FloppyO1/Automatic-Pet-Feeder/firmware/README.txt

DISPENSER AUTOMATICO CROCCHETTE

CARATTERISTICHE:
- Permette di impostare 3 pasti con 3 differenti quantità e ognuno con un orario scelto, e di poterli attivare o disattivare.
- Integra una batteria in caso di mancanza di alimentazione. Permette di mantenere sia l'ora che i vari pasti impostati.
 > nel caso in cui manchi l'alimentazione per un tempo prolungato potrebbe esserci la perdita delle impostazioni.
 > Una volta ricollegato la bateria verrà ricaricata.
 > Le impostazioni e l'ora si dovrà reimpostare.
- Ogni tipo di pasto può essere impostato con una determinata quantità di cibo (la quantità di cibo non è espressa in g).
- Per navigare nei menu si usa dei pulsanti (+, -, enter) che permettono di selezionare e cambiare i valori nelle impostazioni

MENU:
0. Menu avvio

1. Menu principale
 ? permette di visualizzare i pasti della giornata ancora da fare.
 > in basso a destra c'è il simbolo dell'ingranaggio (sempre selezionato) che permette di entrare nel menu ddelle impostaioni.
 > cliccando il pulsante + si darà una quantità predefinita di cibo, premendo più volte viene aumentata la dose fornita.
 > il pulsante - non fa nulla.

2. Menu impostazioni
 ? permette di navigare nei vari menu di impostazione dei parametri dei pasti, dell'ora e dell'attivazione del dispositivo.
 > in basso a destra c'è l'icona dell'ingranaggio che permette di ritornare al menu principale (selezionabile con i pulsanti + e -).
 > premendo i pulsanti + e - permettono di selezionare il menu al quale si vuole accedere.
 > premendo il pulsante enter si accede al menu selezionato dal puntatore < (o nel caso dell'icona dell'ingranaggio dall'evidenziaione dell'incona stessa).

3. Menu impostazioni pasti (MEAL SET. -> MEAL SETTINGS)
 > permette di attivare/disattivare, impostare il tipo di pasto (quindi la quantità), e l'ora alla quale il pasto deve essere servito.
 >
