FloppyO1/Automatic-Pet-Feeder/hardware/schema pet feeder.jpg

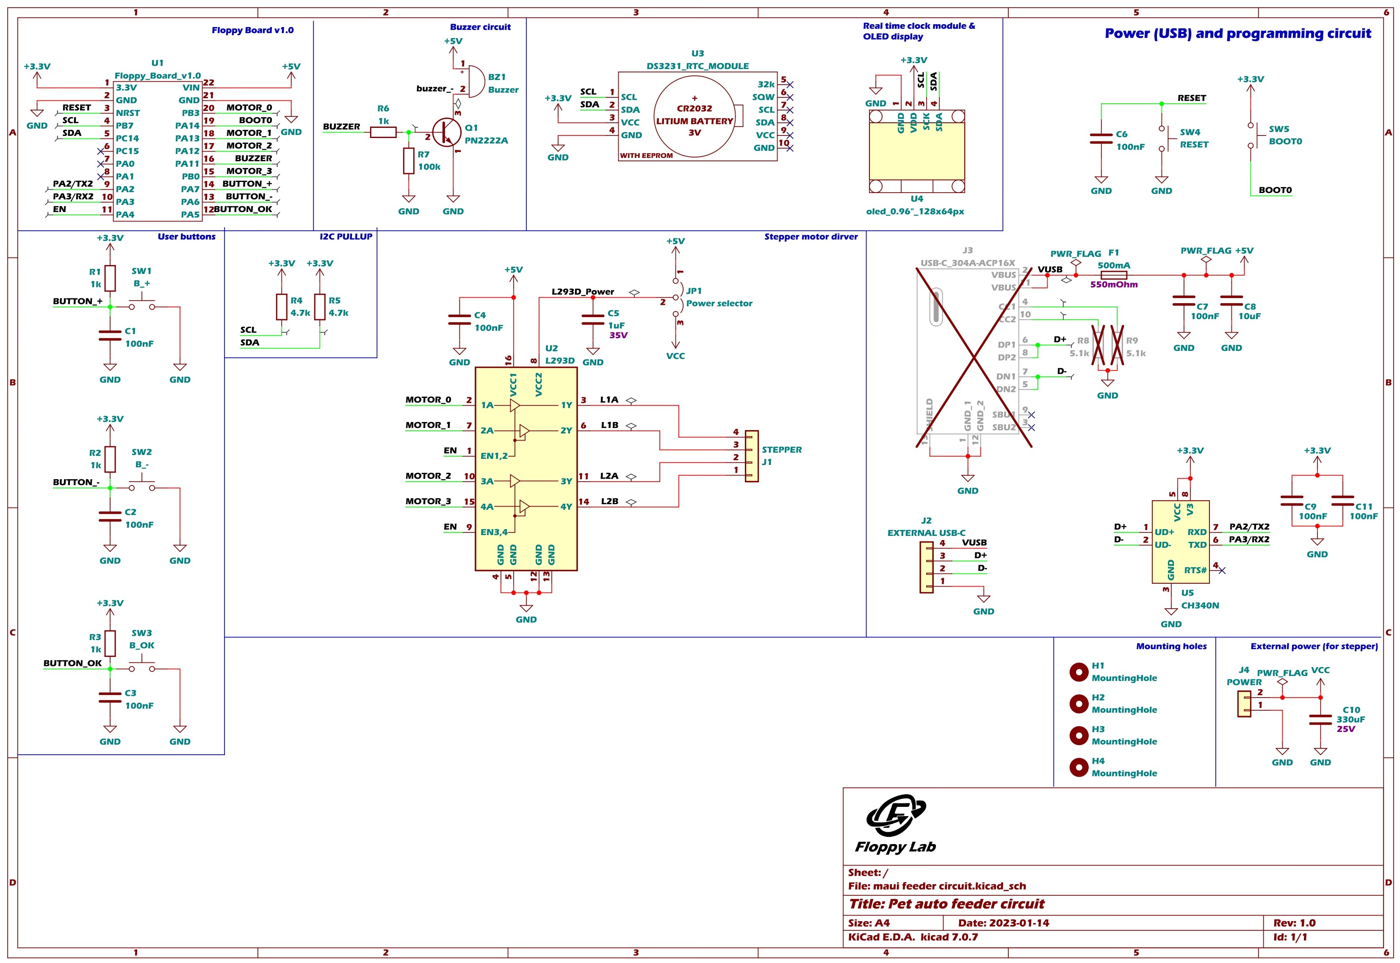
hardware/schema pet feeder.jpg
