FloppyO1/Automatic-Pet-Feeder/hardware/bom Automatic Pet Feeder Control Board.xlsx

REFERENCE | VALUE | FOOTPRINT | QUANTITY
BZ1 | BUZZER | BUZZER P-4mm | 1
C1-C4, C6, C7, C9, C11 | 100 nF | 603 | 8
C5 | 1 uF | 603 | 1
C8 | 10 uF | 603 | 1
C10 | 330 uF | Elec_6.3×7.7mm | 1
F1 | 500mA | 1206 | 1
J1, J2, U3 | connector: stepper/ext_USB/RTC_module | JST_XH_1x4 | 3
J3 | USB-C | USB-C_16pin | 1
J4 | EXT power connector | JST_XH_1x2 | 1
Q1 | PN2222A | TO-92_Inline | 1
R1-R3, R6 | 1 kΩ | 603 | 4
R4, R5 | 4.7 kΩ | 603 | 2
R7 | 100 kΩ | 603 | 1
R8, R9 | 5.1 kΩ | 603 | 2
SW1-SW3 | buttons: +/-/OK | button SMD 5.1×5.1 | 3
SW4, SW5 | buttons: RESET/BOOT0 | button SMD tactile PTS636Sx25 | 2
U2 | L293D | DIP-16 | 1
U4 | Pin Header | Pin Header 1×4 P2.54mm | 1
U5 | CH340N | SOP-8 3.9×4.9mm P1.27mm | 1
