FloppyO1/Automatic-Pet-Feeder/struttura/roba da stampare/dispenser assembly 1.3mf

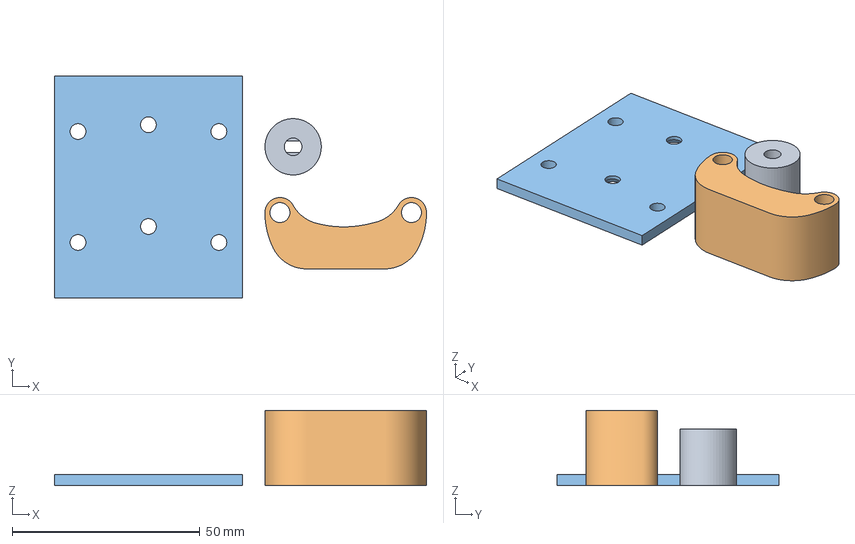
[picture p2: CAD file, 2024-02-22]
struttura/roba da stampare/dispenser assembly 1.3mf
99.0 x 59.0 x 20.0 mm
giunto motore
attacco motore
attacco per ciotola
