FloppyO1/Automatic-Pet-Feeder/struttura/circuito/Assieme case circuito.SLDASM

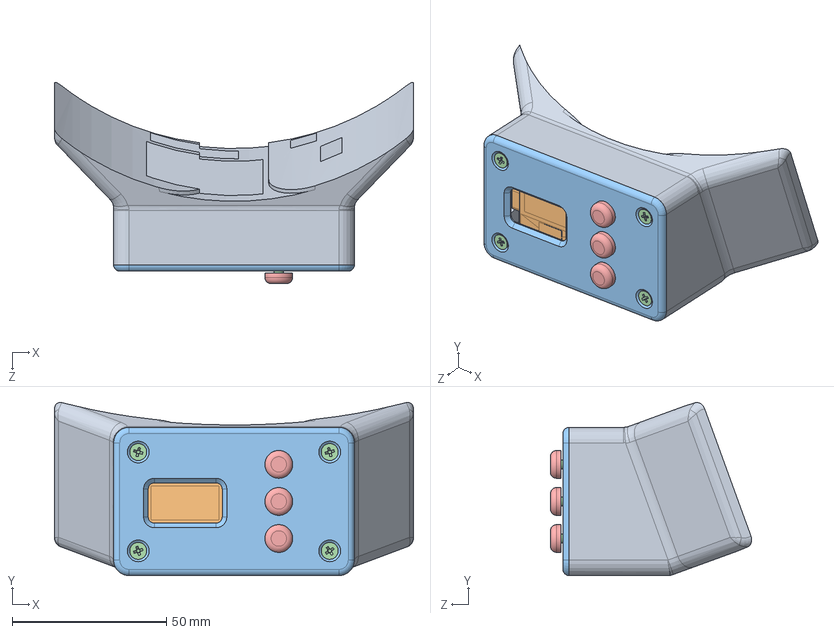
[picture p3: CAD file, 2024-02-22]
struttura/circuito/Assieme case circuito.SLDASM
116.2 x 56.1 x 65.2 mm
case 1
circuito
coperchio case
countersunk flat head cross recess screw_iso x 7
botton 2.0 x 3
