FloppyO1/Automatic-Pet-Feeder/struttura/roba da stampare/dispenser assembly 2.3MF

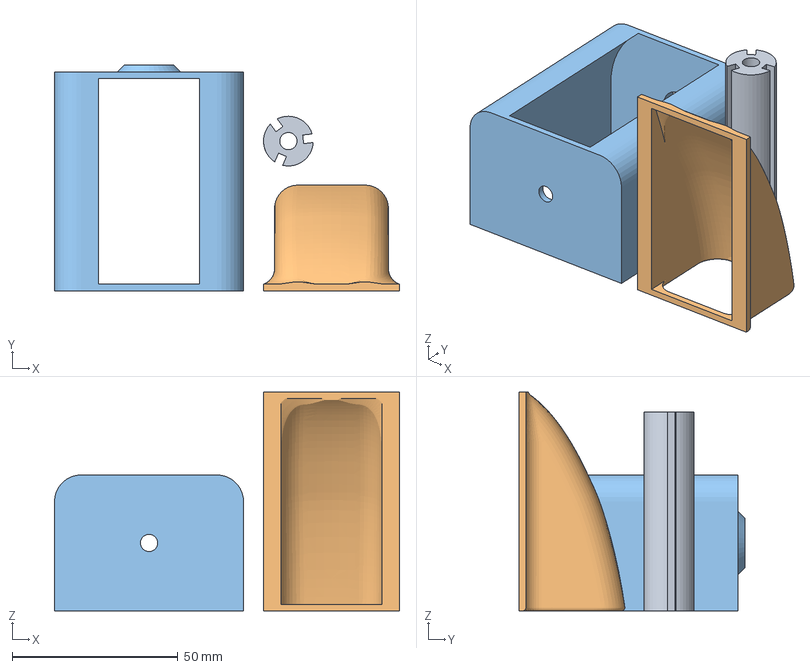
[picture p4: CAD file, 2024-02-22]
struttura/roba da stampare/dispenser assembly 2.3MF
104.0 x 68.0 x 66.0 mm
