FloppyO1/Automatic-Pet-Feeder/struttura/Assieme1 completo.SLDASM

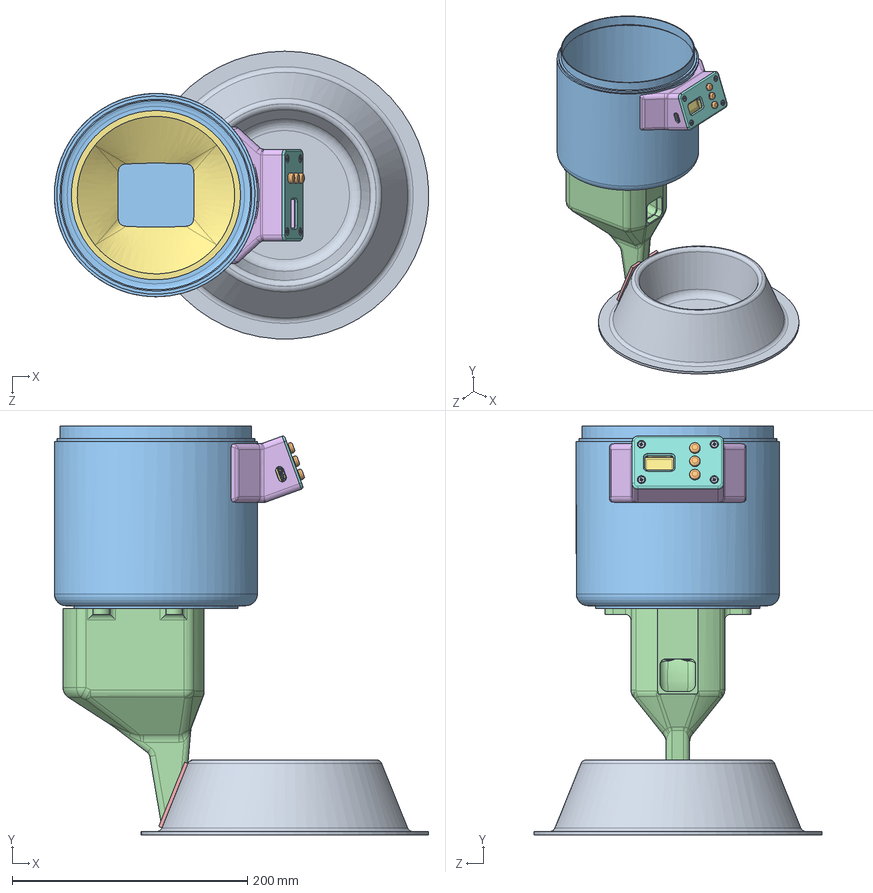
[picture p5: CAD file, 2024-02-22]
struttura/Assieme1 completo.SLDASM
318.6 x 348.0 x 244.8 mm
ciotola
perno rotante
case
convogliatore
giunto motore
attacco motore
cono intern
spazzola x 3
radial ball bearing_68_iso
stepper 24BYJ-48
Bursolotto
sostegno dispenser
attacco per ciotola
case 1
circuito
coperchio case
countersunk flat head cross recess screw_iso x 7
botton 2.0 x 3
