FloppyO1/Automatic-Pet-Feeder/struttura/dispenser/ASSIEME dispenser.SLDASM

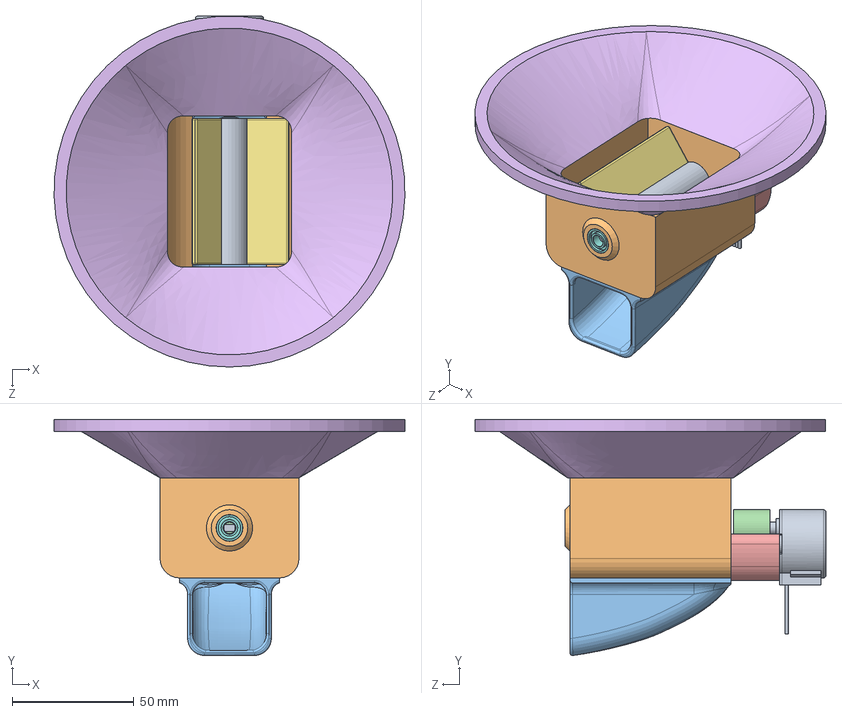
[picture p6: CAD file, 2024-02-22]
struttura/dispenser/ASSIEME dispenser.SLDASM
143.9 x 96.9 x 144.0 mm
perno rotante
case
convogliatore
giunto motore
attacco motore
cono intern
spazzola x 3
radial ball bearing_68_iso
stepper 24BYJ-48
