FloppyO1/Automatic-Pet-Feeder/struttura/attacco per ciotola inclinato .SLDPRT

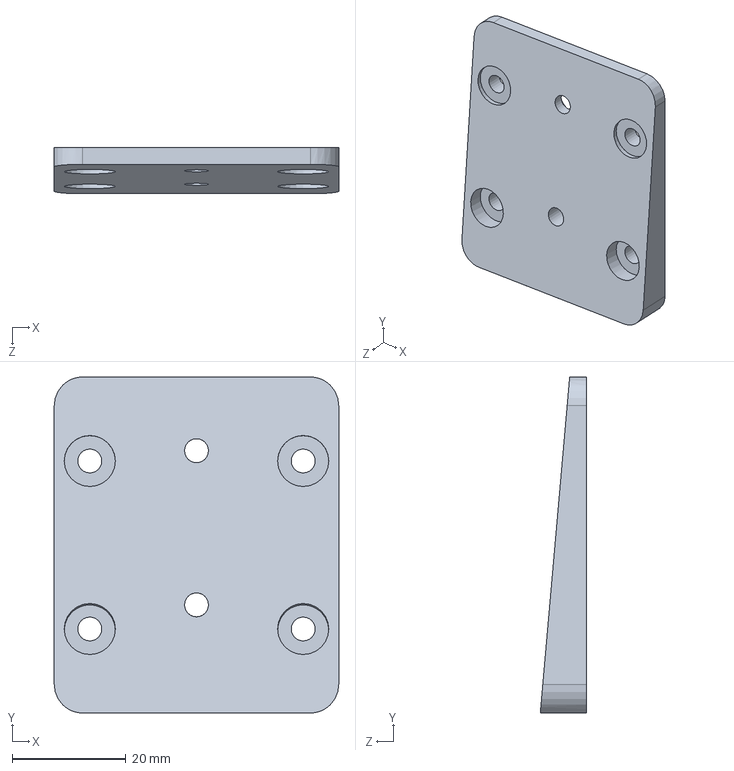
[picture p7: CAD file, 2024-02-22]
struttura/attacco per ciotola inclinato .SLDPRT
50.0 x 59.0 x 8.17 mm
