FloppyO1/Automatic-Pet-Feeder/struttura/circuito/pulsante.SLDPRT

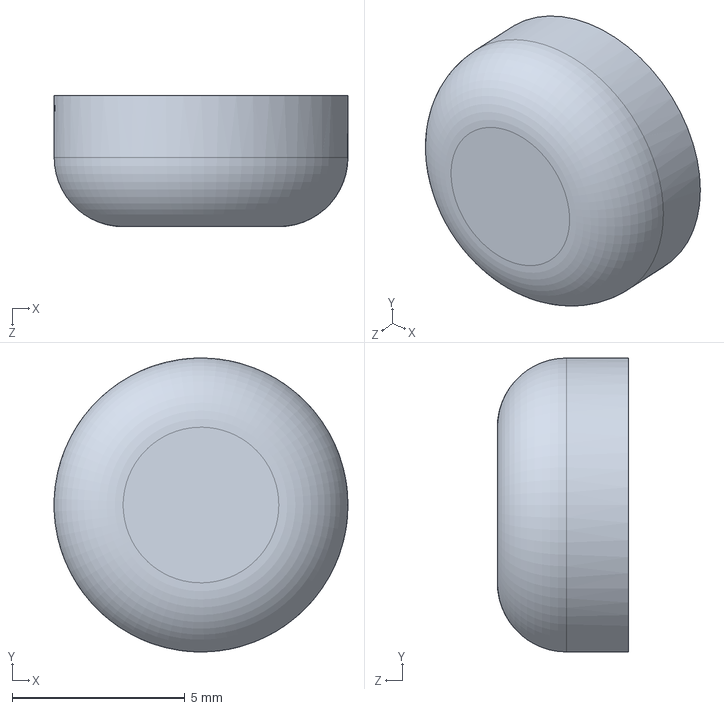
[picture p8: CAD file, 2024-02-22]
struttura/circuito/pulsante.SLDPRT
8.50 x 8.50 x 3.80 mm
