FloppyO1/Automatic-Pet-Feeder/struttura/dispenser/convogliatore.SLDPRT

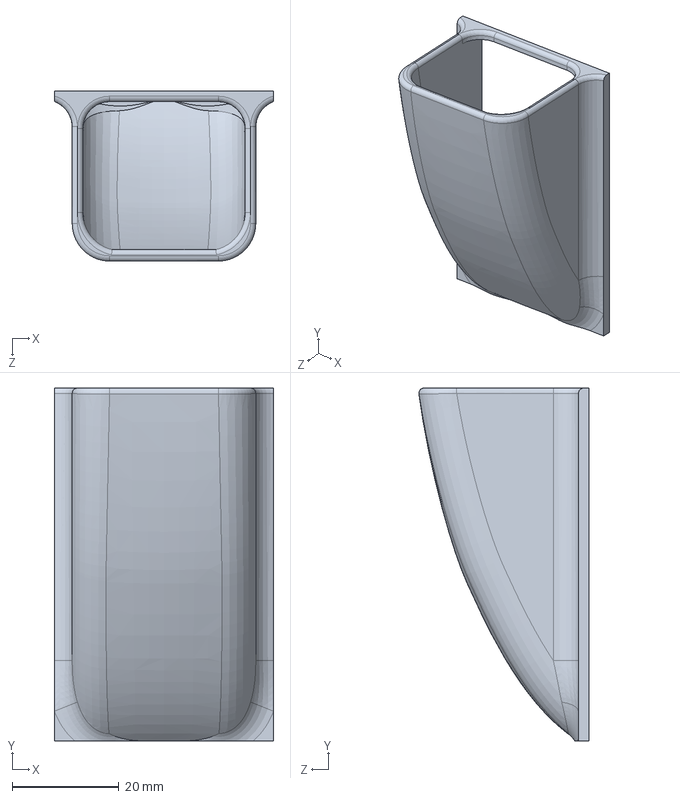
[picture p9: CAD file, 2024-02-22]
struttura/dispenser/convogliatore.SLDPRT
41.0 x 66.0 x 31.9 mm
