FloppyO1/Automatic-Pet-Feeder/struttura/circuito/coperchio case.SLDPRT

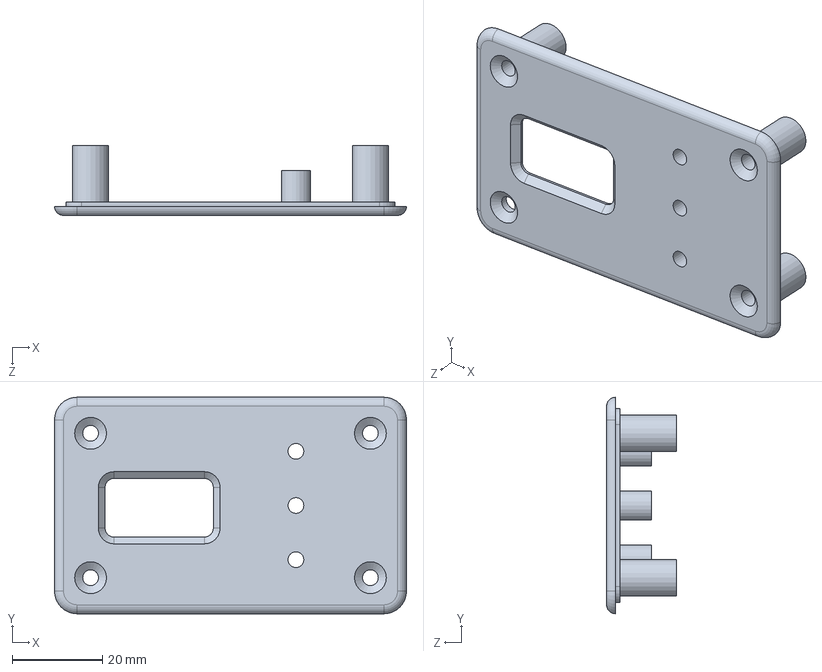
[picture p10: CAD file, 2024-02-22]
struttura/circuito/coperchio case.SLDPRT
78.0 x 48.0 x 15.5 mm
