FloppyO1/Automatic-Pet-Feeder/struttura/dispenser/perno rotante.SLDPRT

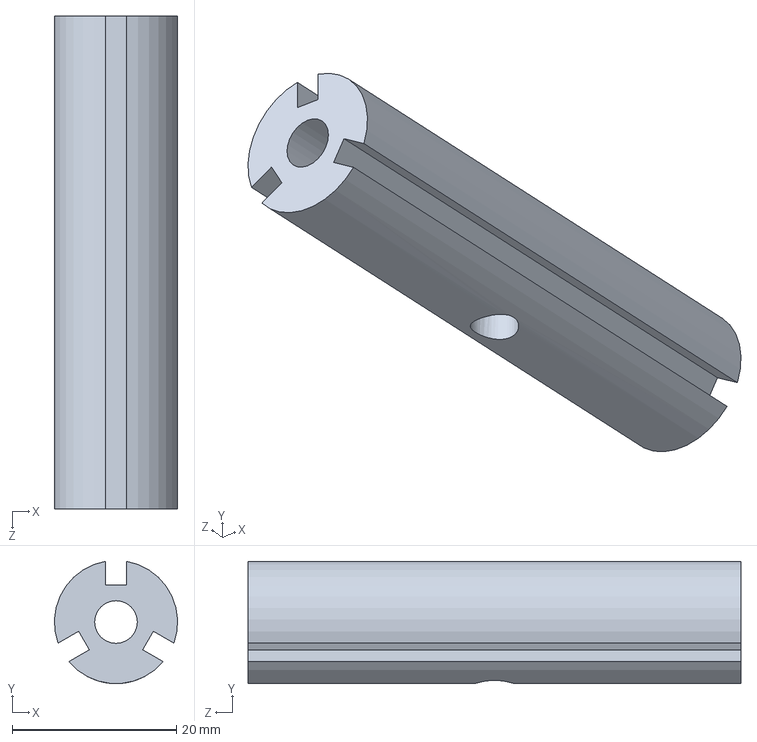
[picture p11: CAD file, 2024-02-22]
struttura/dispenser/perno rotante.SLDPRT
15.0 x 14.9 x 60.0 mm
