FloppyO1/Automatic-Pet-Feeder/struttura/roba da stampare/funnel.3MF

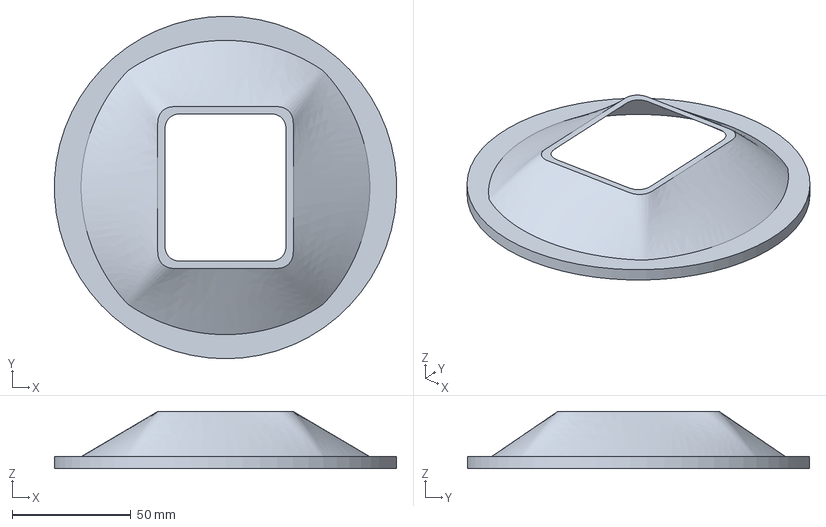
[picture p12: CAD file, 2024-02-22]
struttura/roba da stampare/funnel.3MF
143.8 x 144.0 x 24.0 mm
