FloppyO1/Automatic-Pet-Feeder/struttura/stepper 24BYJ-48.SLDPRT

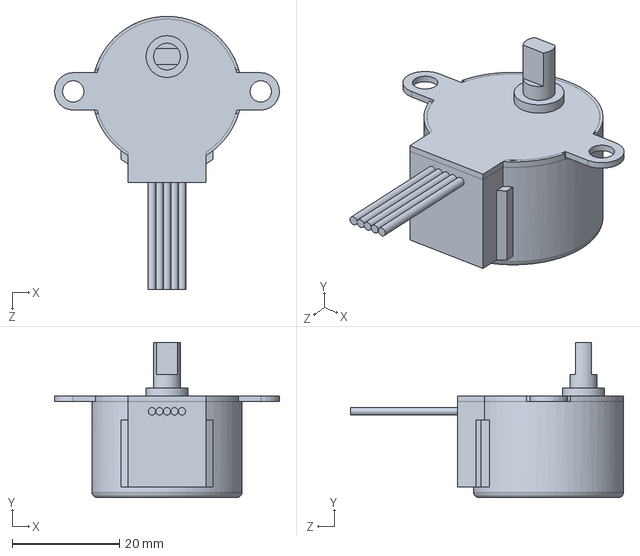
[picture p13: CAD file, 2024-02-22]
struttura/stepper 24BYJ-48.SLDPRT
42.0 x 29.0 x 51.0 mm
