FloppyO1/Automatic-Pet-Feeder/struttura/Bursolotto.SLDPRT

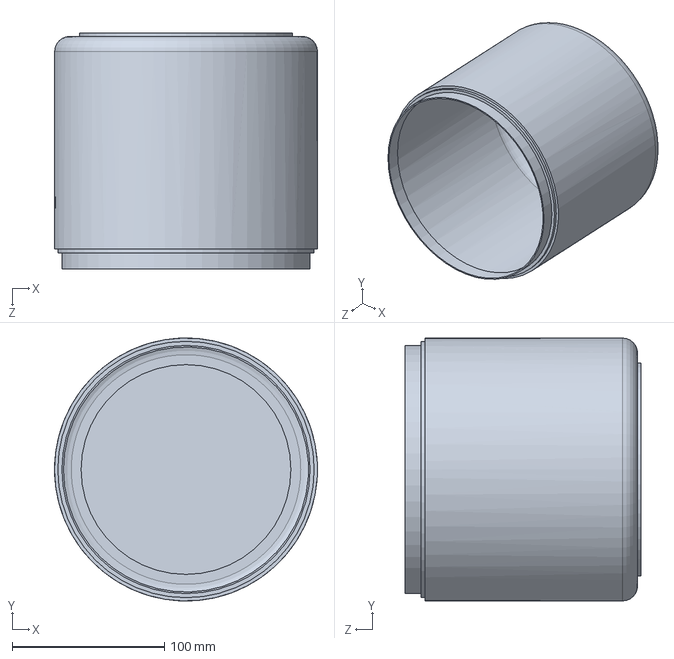
[picture p14: CAD file, 2024-02-22]
struttura/Bursolotto.SLDPRT
173.0 x 173.0 x 155.2 mm
