FloppyO1/Automatic-Pet-Feeder/struttura/circuito/case 1.SLDPRT

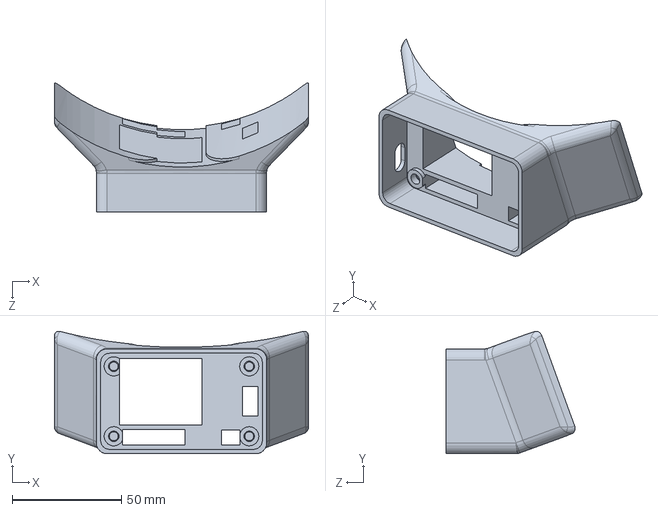
[picture p15: CAD file, 2024-02-22]
struttura/circuito/case 1.SLDPRT
116.2 x 56.1 x 59.1 mm
