FloppyO1/Automatic-Pet-Feeder/struttura/dispenser/spazzola.SLDPRT

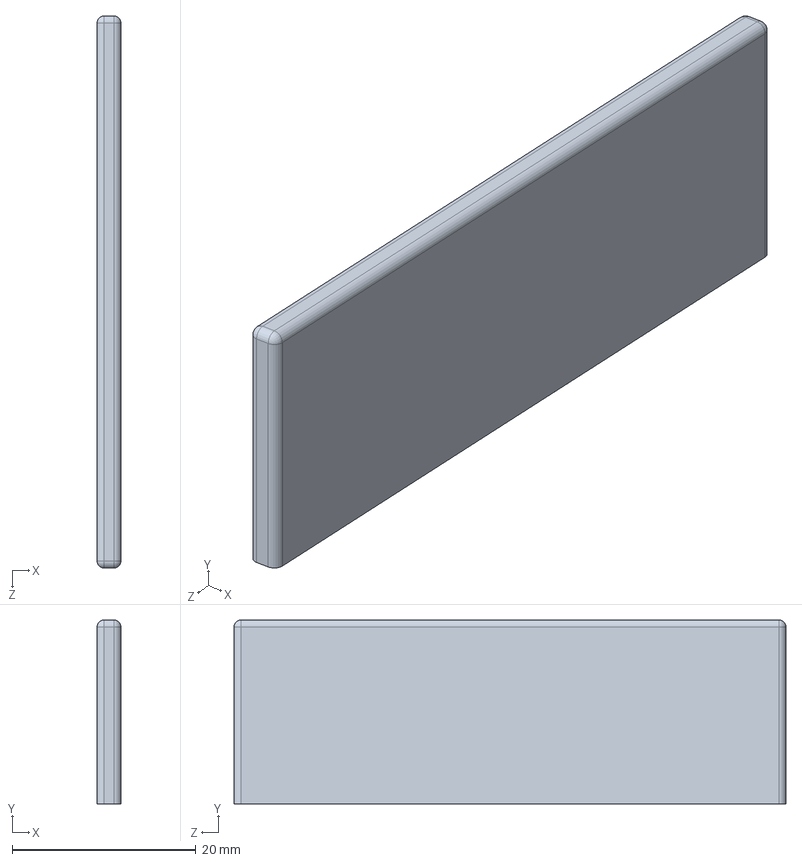
[picture p16: CAD file, 2024-02-22]
struttura/dispenser/spazzola.SLDPRT
2.60 x 20.0 x 60.0 mm
