FloppyO1/Automatic-Pet-Feeder/struttura/attacco motore.SLDPRT

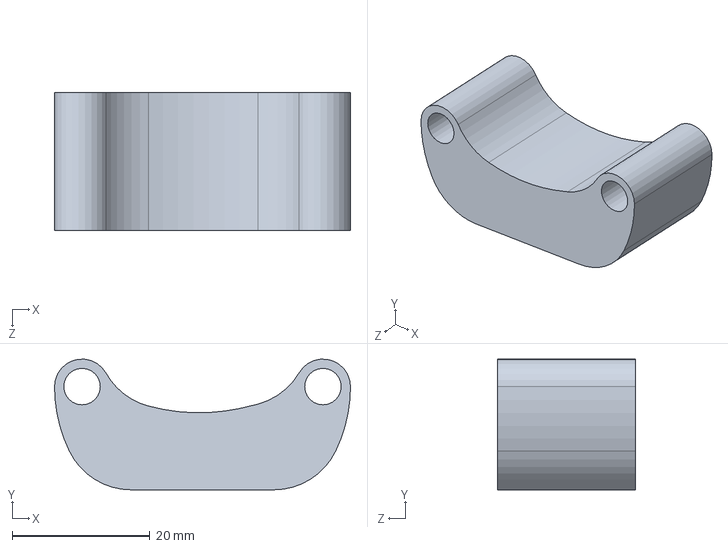
[picture p17: CAD file, 2024-02-22]
struttura/attacco motore.SLDPRT
43.0 x 19.0 x 20.0 mm
