FloppyO1/Automatic-Pet-Feeder/struttura/circuito/botton 2.0.SLDPRT

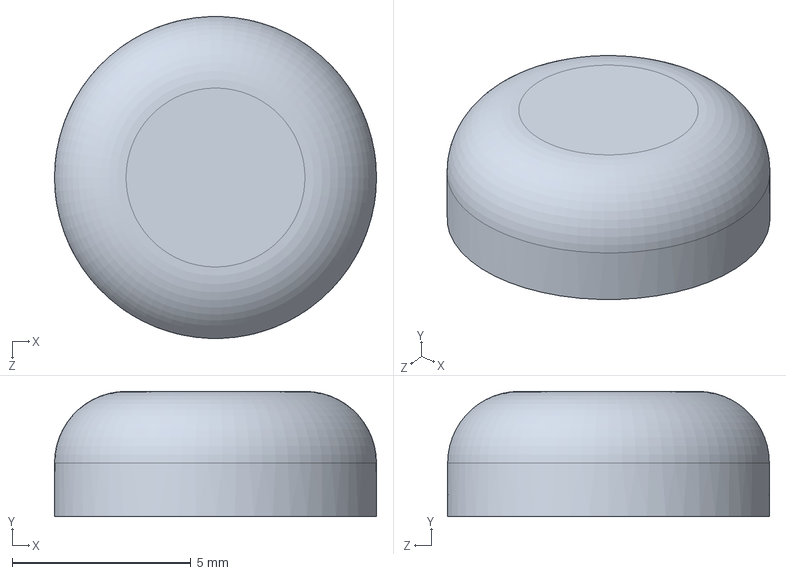
[picture p18: CAD file, 2024-02-22]
struttura/circuito/botton 2.0.SLDPRT
9.00 x 3.50 x 9.00 mm
