FloppyO1/Automatic-Pet-Feeder/struttura/roba da stampare/dispenser mount.3MF

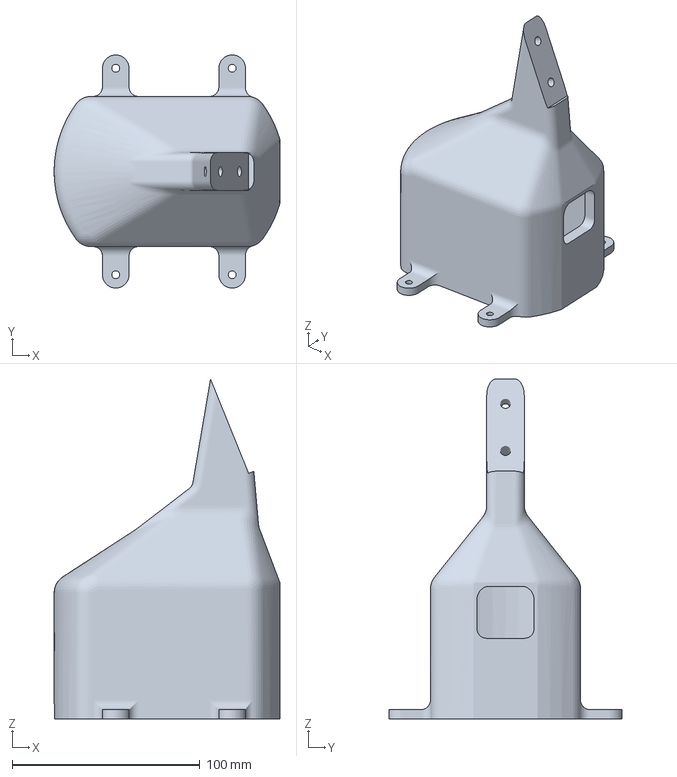
[picture p19: CAD file, 2024-02-22]
struttura/roba da stampare/dispenser mount.3MF
120.2 x 124.2 x 181.1 mm
