FloppyO1/Automatic-Pet-Feeder/struttura/attacco per ciotola.SLDPRT

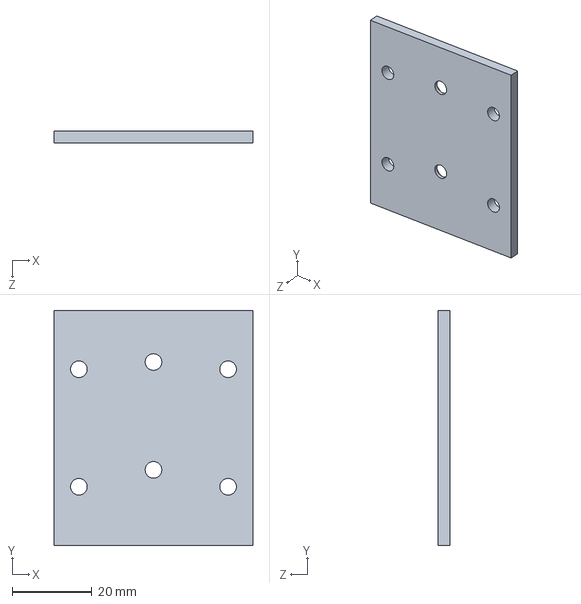
[picture p20: CAD file, 2024-02-22]
struttura/attacco per ciotola.SLDPRT
50.0 x 59.0 x 3.00 mm
