FloppyO1/Automatic-Pet-Feeder/struttura/roba da stampare/circuit case.3MF

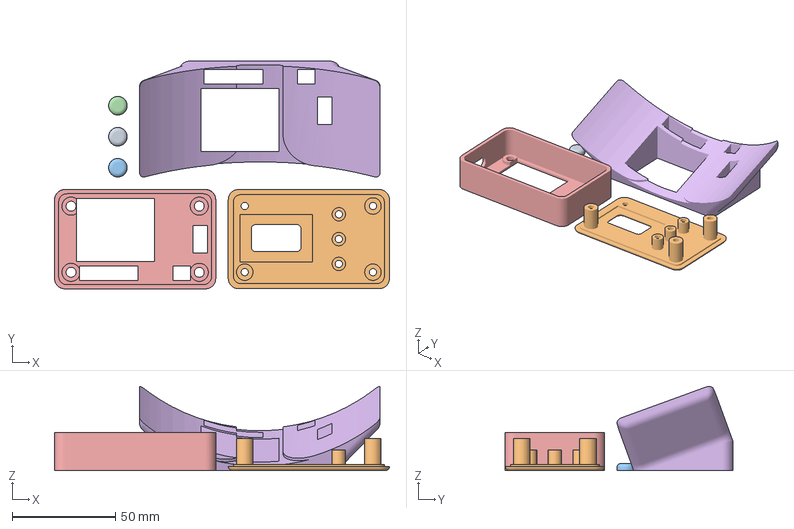
[picture p21: CAD file, 2024-02-22]
struttura/roba da stampare/circuit case.3MF
162.0 x 110.1 x 40.7 mm
