FloppyO1/Automatic-Pet-Feeder/struttura/dispenser/case.SLDPRT

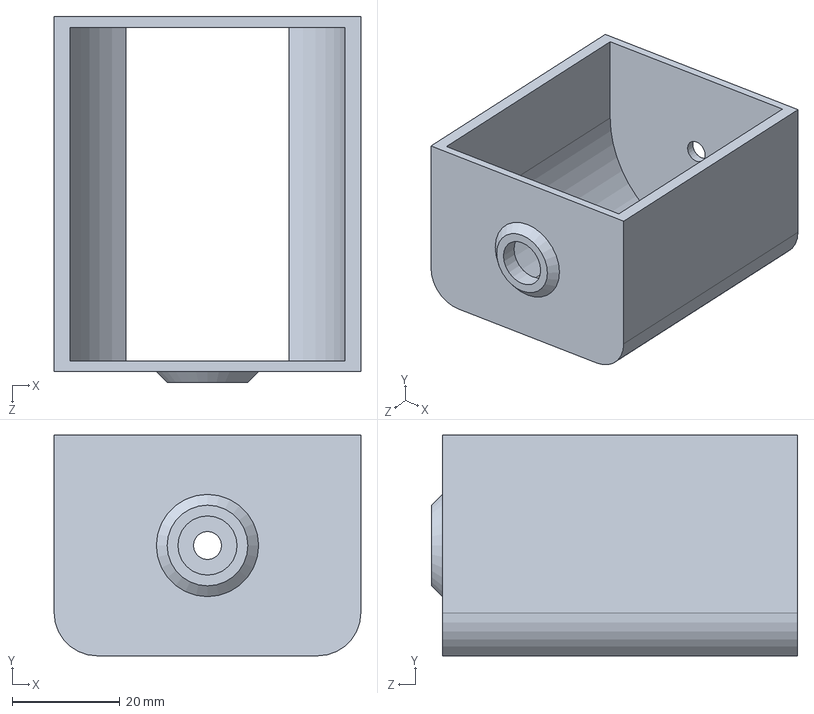
[picture p22: CAD file, 2024-02-22]
struttura/dispenser/case.SLDPRT
57.0 x 41.0 x 68.0 mm
