FloppyO1/Automatic-Pet-Feeder/struttura/dispenser/ciotola.SLDPRT

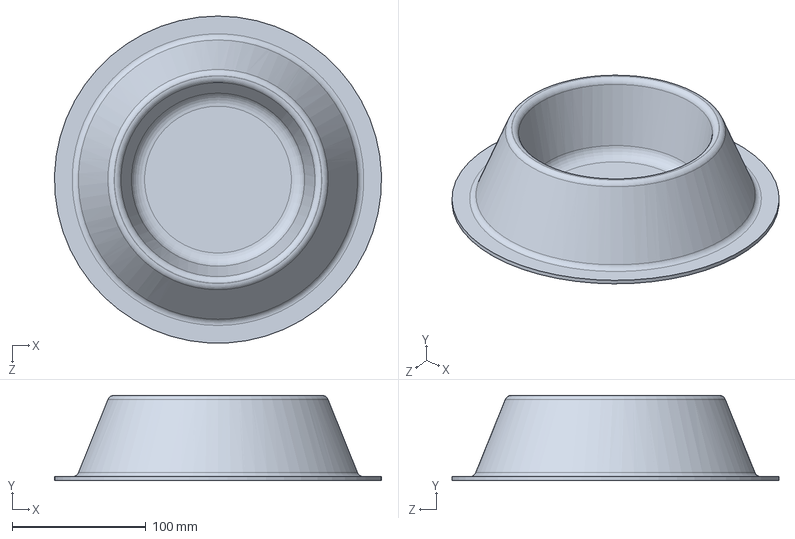
[picture p23: CAD file, 2024-02-22]
struttura/dispenser/ciotola.SLDPRT
244.9 x 64.0 x 244.8 mm
