FloppyO1/Automatic-Pet-Feeder/struttura/giunto motore.SLDPRT

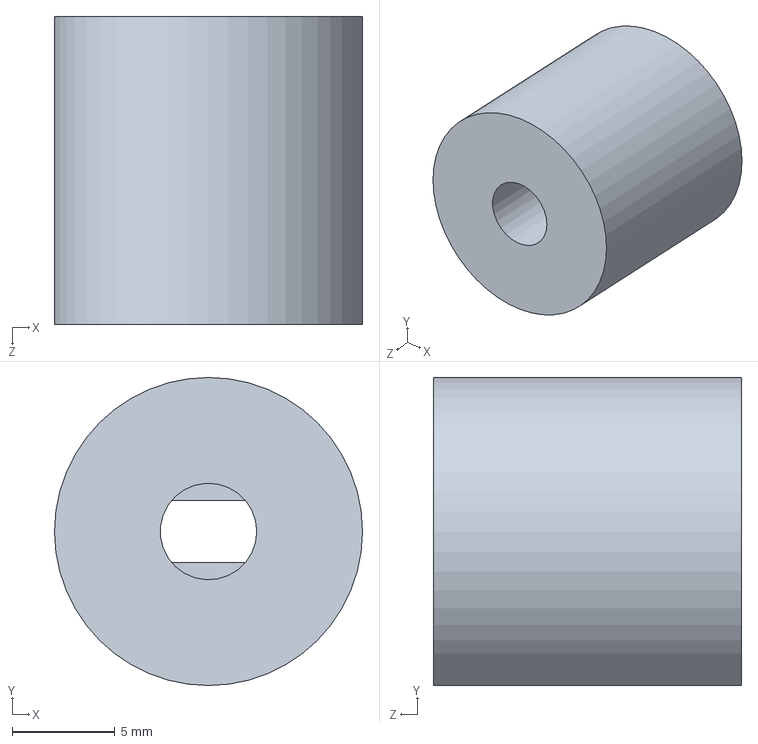
[picture p24: CAD file, 2024-02-22]
struttura/giunto motore.SLDPRT
15.0 x 15.0 x 15.0 mm
