FloppyO1/Automatic-Pet-Feeder/(list of files, cad)

Other CAD files:
struttura/roba da stampare/attacco per ciotola inclinato .3MF
struttura/dispenser/LID1.SLDPRT
struttura/dispenser/LID3.SLDPRT
struttura/sostegno dispenser.SLDPRT
struttura/dispenser/cono intern.SLDPRT
struttura/dispenser/LID2.SLDPRT
