FloppyO1/Automatic-Pet-Feeder/hardware/schema pet feeder.pdf

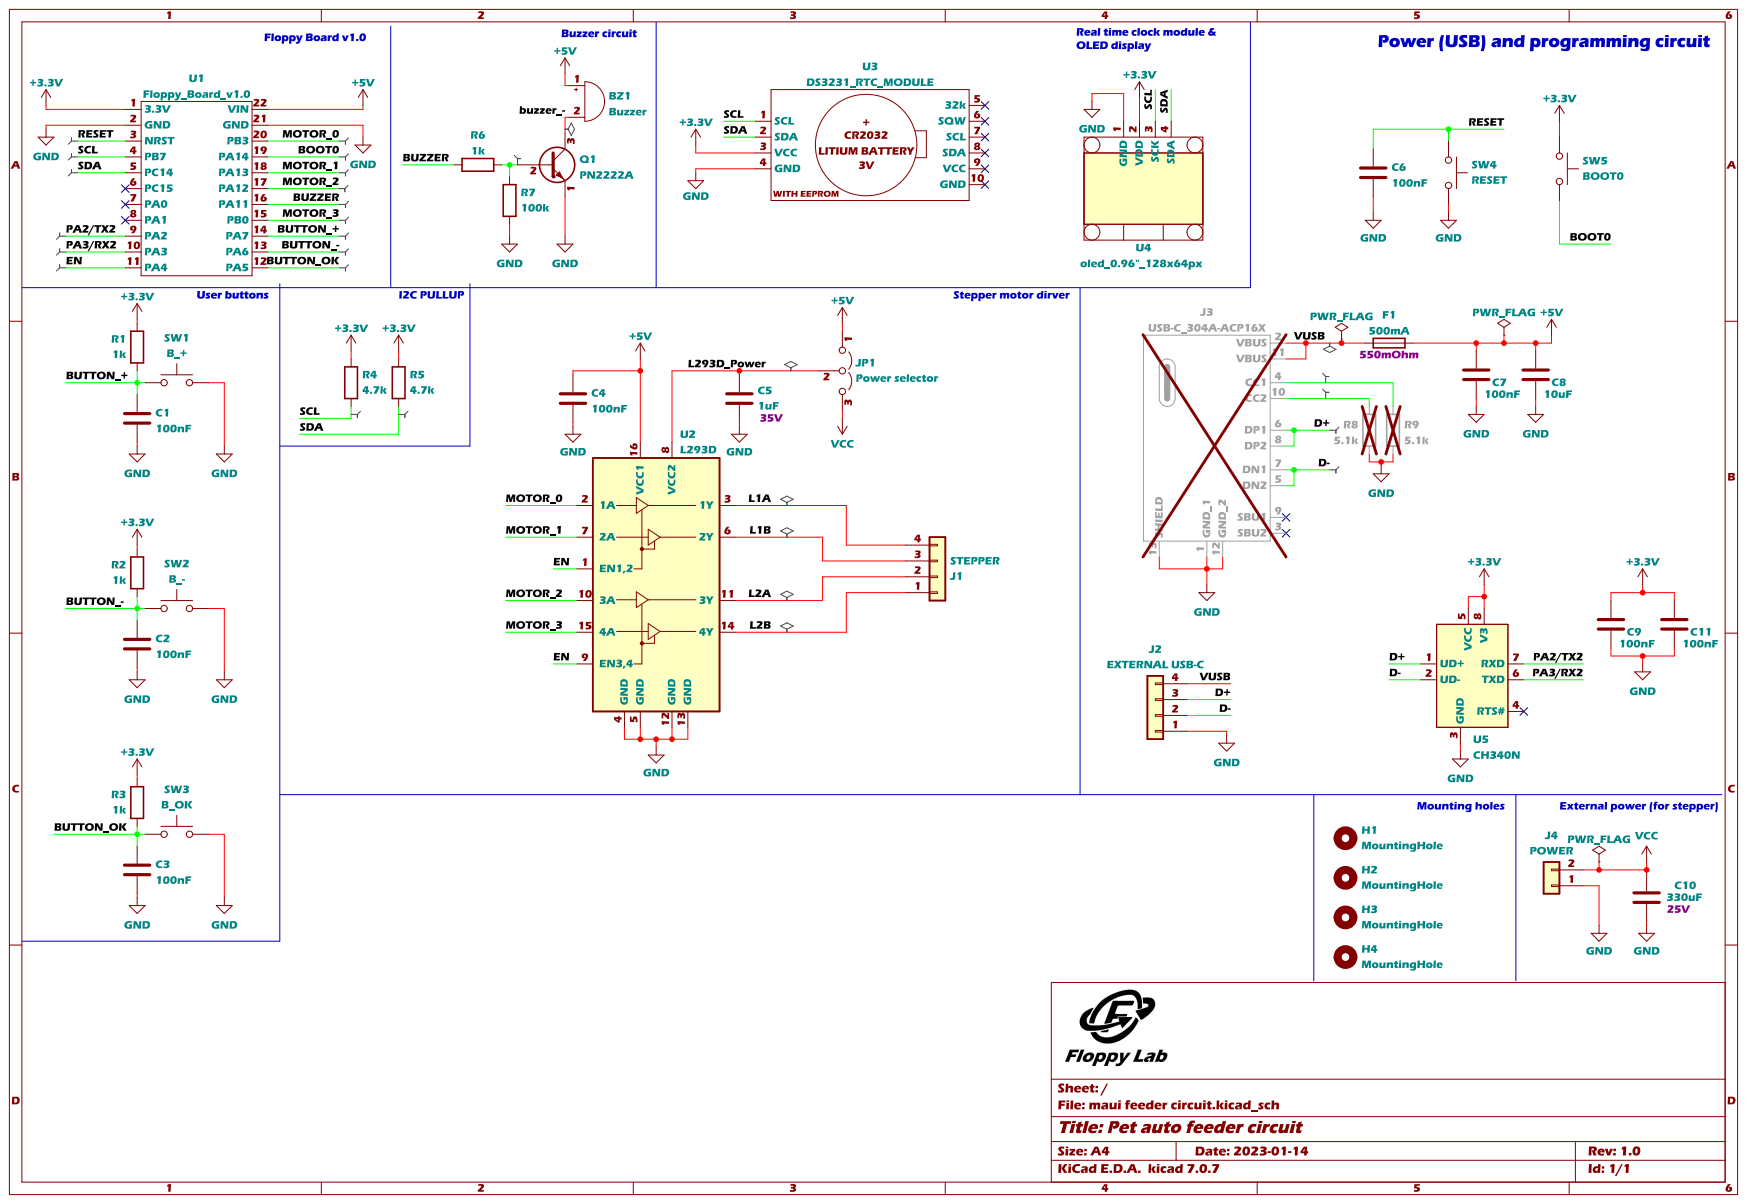
[picture p25: page 1]
