FloppyO1/Automatic-Pet-Feeder/hardware/maui feeder circuit/maui feeder circuit.kicad_pcb

## KiCad design hardware/maui feeder circuit/maui feeder circuit.kicad_pcb (2024-02-22)

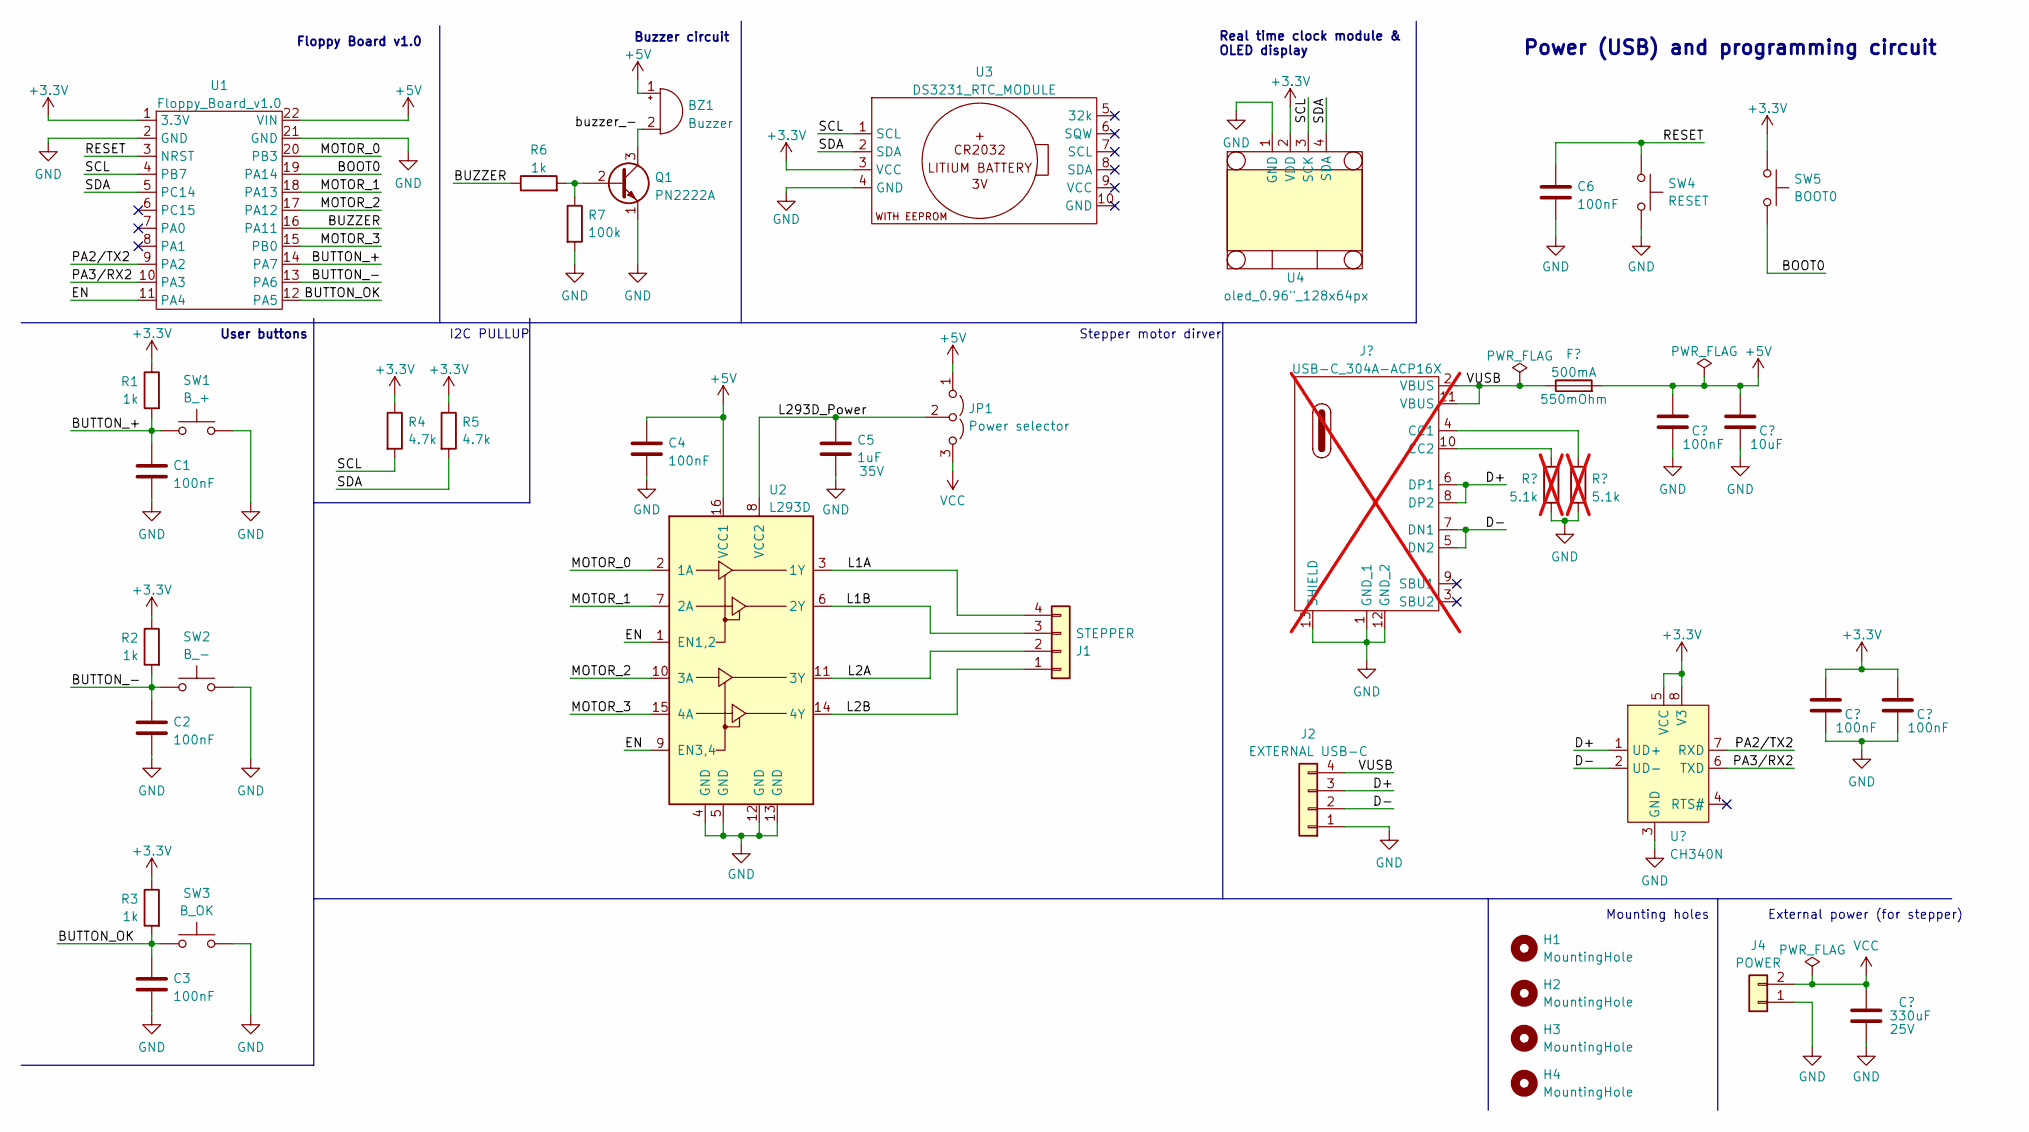
[picture p26: schematic maui feeder circuit.kicad_sch, Pet auto feeder circuit]

Parts:
BZ1: Buzzer; MagneticBuzzer_PUI_AT-0927-TT-6-R
C1, C2, C3, C4, C6, C7, C9, C11: 100nF; C_0603_1608Metric
C5: 1uF; C_0603_1608Metric; Voltage 35V
C8: 10uF; C_0603_1608Metric
C10: 330uF; CP_Elec_6.3x7.7; Voltage 25V
F1: 500mA; Fuse_1206_3216Metric_Pad1.42x1.75mm_HandSolder
H1, H2, H3, H4: MountingHole; MountingHole_3.2mm_M3_Pad
J1: STEPPER; JST_XH_B4B-XH-A_1x04_P2.50mm_Vertical
J2: EXTERNAL USB-C; JST_XH_B4B-XH-A_1x04_P2.50mm_Vertical
J3: USB-C_304A-ACP16X; USB_C_304A-ACP16X; not fitted
J4: POWER; JST_XH_B2B-XH-A_1x02_P2.50mm_Vertical
JP1: Power selector; SolderJumper-3_P1.3mm_Open_RoundedPad1.0x1.5mm
Q1: PN2222A; TO-92_Inline
R1, R2, R3, R6: 1k; R_0603_1608Metric
R4, R5: 4.7k; R_0603_1608Metric
R7: 100k; R_0603_1608Metric
R8, R9: 5.1k; R_0603_1608Metric; not fitted
SW1: B_+; SMD BUTTON 5.1x5.1
SW2: B_-; SMD BUTTON 5.1x5.1
SW3: B_OK; SMD BUTTON 5.1x5.1
SW4: RESET; SW_Tactile_SPST_NO_Straight_CK_PTS636Sx25SMTRLFS
SW5: BOOT0; SW_Tactile_SPST_NO_Straight_CK_PTS636Sx25SMTRLFS
U1: Floppy_Board_v1.0; Floppy board v1.0
U2: L293D; DIP-16_W7.62mm
U3: DS3231_RTC_MODULE; JST_XH_B4B-XH-A_1x04_P2.50mm_Vertical
U4: oled_0.96"_128x64px; 128x64OLED
U5: CH340N; SOP-8_3.9x4.9mm_P1.27mm

Connections:
+3.3V: C9.1, C11.1, R1.1, R2.1, R3.1, R4.1, R5.1, SW5.1, U1.1 (3.3V), U3.3 (VCC), U4.2 (VDD), U5.5 (VCC), U5.8 (V3)
+5V: BZ1.1 (-), C4.1, C7.1, C8.1, F1.2, JP1.1 (A), U1.22 (VIN), U2.16 (VCC1)
/BOOT0: SW5.2, U1.19 (PA14)
/BUTTON_+: C1.1, R1.2, SW1.1, U1.14 (PA7)
/BUTTON_-: C2.1, R2.2, SW2.1, U1.13 (PA6)
/BUTTON_OK: C3.1, R3.2, SW3.1, U1.12 (PA5)
/BUZZER: R6.1, U1.16 (PA11)
/D+: J2.3, J3.6 (DP1), J3.8 (DP2), U5.1 (UD+)
/D-: J2.2, J3.5 (DN2), J3.7 (DN1), U5.2 (UD-)
/EN: U1.11 (PA4), U2.1 (EN1,2), U2.9 (EN3,4)
/L1A: J1.4, U2.3 (1Y)
/L1B: J1.3, U2.6 (2Y)
/L2A: J1.2, U2.11 (3Y)
/L2B: J1.1, U2.14 (4Y)
/L293D_Power: C5.1, JP1.2 (C), U2.8 (VCC2)
/MOTOR_0: U1.20 (PB3), U2.2 (1A)
/MOTOR_1: U1.18 (PA13), U2.7 (2A)
/MOTOR_2: U1.17 (PA12), U2.10 (3A)
/MOTOR_3: U1.15 (PB0), U2.15 (4A)
/PA2/TX2: U1.9 (PA2), U5.7 (RXD)
/PA3/RX2: U1.10 (PA3), U5.6 (TXD)
/RESET: C6.1, SW4.1, U1.3 (NRST)
/SCL: R4.2, U1.4 (PB7), U3.1 (SCL), U4.3 (SCK)
/SDA: R5.2, U1.5 (PC14), U3.2 (SDA), U4.4 (SDA)
/VUSB: F1.1, J2.4, J3.2 (VBUS), J3.11 (VBUS)
/buzzer_-: BZ1.2 (+), Q1.3 (C)
GND: C1.2, C2.2, C3.2, C4.2, C5.2, C6.2, C7.2, C8.2, C9.2, C10.2, C11.2, J2.1, J3.1 (GND_1), J3.12 (GND_2), J3.13 (SHIELD), J4.1, Q1.1 (E), R7.2, R8.1, R9.2, SW1.2, SW2.2, SW3.2, SW4.2, U1.2 (GND), U1.21 (GND), U2.4 (GND), U2.5 (GND), U2.12 (GND), U2.13 (GND), U3.4 (GND), U4.1 (GND), U5.3 (GND)
unnamed: J3.4 (CC1), R9.1
unnamed: J3.10 (CC2), R8.2
unnamed: Q1.2 (B), R6.2, R7.1
VCC: C10.1, J4.2, JP1.3 (B)

Notes on the sheet:
External power (for stepper)
Stepper motor dirver
Real time clock module & OLED display
Buzzer circuit
Power (USB) and programming circuit
I2C PULLUP
Floppy Board v1.0
User buttons
Mounting holes

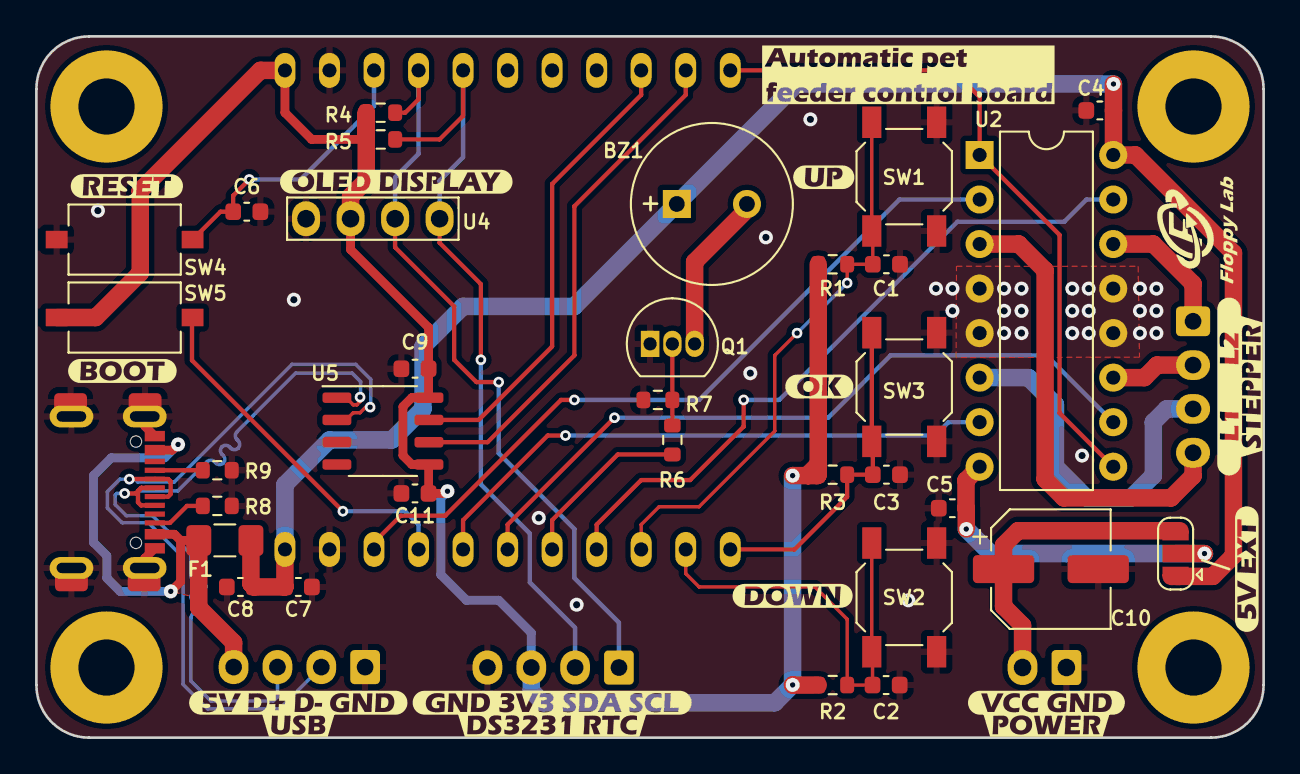
[picture p27: board maui feeder circuit.kicad_pcb from above]

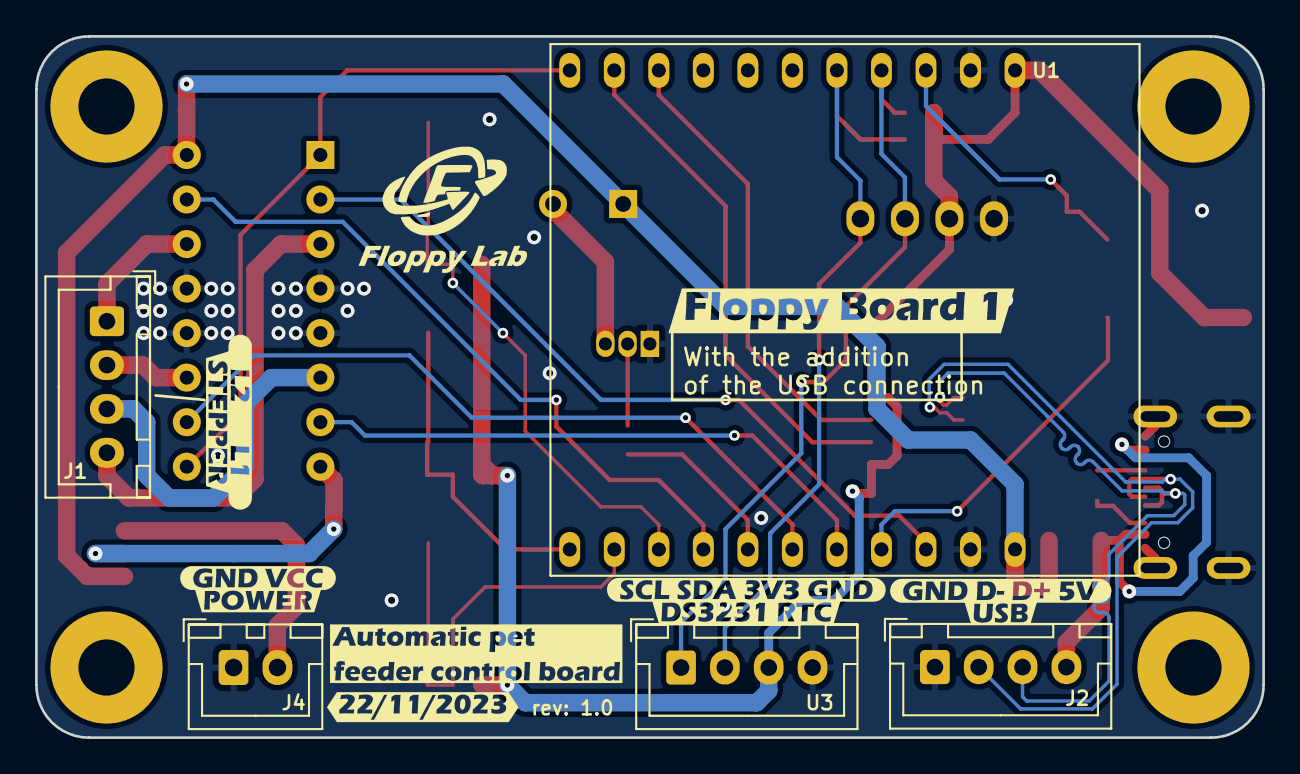
[picture p28: board maui feeder circuit.kicad_pcb from below]

Board: 2 copper layers, 70.0 x 40.0 mm, 69 parts (16 on the bottom side), 31 nets.

Other parts of the board:
kibuzzard-655E5A8C, kibuzzard-655E5A8C#2: G***; kibuzzard-655E5A8C
kibuzzard-655E5A9C: G***; kibuzzard-655E5A9C
kibuzzard-655E5ABC: G***; kibuzzard-655E5ABC
kibuzzard-655E5B7A: G***; kibuzzard-655E5B7A
kibuzzard-655E5B48: G***; kibuzzard-655E5B48
kibuzzard-655E5B52, kibuzzard-655E5B52#2: G***; kibuzzard-655E5B52
kibuzzard-655E5B87: G***; kibuzzard-655E5B87
kibuzzard-655E5B91: G***; kibuzzard-655E5B91
kibuzzard-655E5BB9: G***; kibuzzard-655E5BB9
kibuzzard-655E5BC2: G***; kibuzzard-655E5BC2
kibuzzard-655E6B51: G***; kibuzzard-655E6B51
kibuzzard-655E6C3A, kibuzzard-655E6C3A#2: G***; kibuzzard-655E6C3A
kibuzzard-655E6C5E: G***; kibuzzard-655E6C5E
kibuzzard-655E6CD0: G***; kibuzzard-655E6CD0
kibuzzard-655E6CF0: G***; kibuzzard-655E6CF0
kibuzzard-655E6D66: G***; kibuzzard-655E6D66
kibuzzard-655E6DEF: G***; kibuzzard-655E6DEF
kibuzzard-655E59BB, kibuzzard-655E59BB#2: G***; kibuzzard-655E59BB
kibuzzard-655E59DB, kibuzzard-655E59DB#2: G***; kibuzzard-655E59DB
kibuzzard-655E59EA: G***; kibuzzard-655E59EA
kibuzzard-655E71CE: G***; kibuzzard-655E71CE
kibuzzard-655E598F: G***; kibuzzard-655E598F
