FloppyO1/Automatic-Pet-Feeder/firmware/automatic pet feeder/Core/Inc/main.h

#define USER_LED_Pin GPIO_PIN_15
#define USER_LED_GPIO_Port GPIOC
#define ENTER_B_Pin GPIO_PIN_5
#define ENTER_B_GPIO_Port GPIOA
#define ENTER_B_EXTI_IRQn EXTI4_15_IRQn
#define MINUS_B_Pin GPIO_PIN_6
#define MINUS_B_GPIO_Port GPIOA
#define MINUS_B_EXTI_IRQn EXTI4_15_IRQn
#define PLUS_B_Pin GPIO_PIN_7
#define PLUS_B_GPIO_Port GPIOA
#define PLUS_B_EXTI_IRQn EXTI4_15_IRQn
#define MOT3_Pin GPIO_PIN_0
#define MOT3_GPIO_Port GPIOB
#define BUZZER_Pin GPIO_PIN_11
#define BUZZER_GPIO_Port GPIOA
#define MOT2_Pin GPIO_PIN_12
#define MOT2_GPIO_Port GPIOA
#define MOT1_Pin GPIO_PIN_13
#define MOT1_GPIO_Port GPIOA
#define MOT0_Pin GPIO_PIN_3
#define MOT0_GPIO_Port GPIOB
