FloppyO1/Automatic-Pet-Feeder/firmware/automatic pet feeder/Core/Inc/motor.h

/*
 * motor.h
 *
 *  Created on: Dec 9, 2023
 *      Author: Filippo Castellan
 */

#ifndef INC_MOTOR_H_
#define INC_MOTOR_H_

uint8_t quatrerTurn(uint8_t n);

void disableMotor();

void printFeeding();

#endif /* INC_MOTOR_H_ */
