FloppyO1/Automatic-Pet-Feeder/firmware/automatic pet feeder/Core/Inc/bitmap.h

/*
 * bitmap.h
 *
 *  Created on: 19 nov 2022
 *      Author: Filippo Castellan
 */

#ifndef INC_BITMAP_H_
#define INC_BITMAP_H_

const unsigned char ingranaggio[] = { 0x00, 0x00, 0x6d, 0x80, 0x7f, 0x80, 0x3f,
		0x00, 0x73, 0x80, 0x73, 0x80, 0x3f, 0x00, 0x7f, 0x80, 0x6d, 0x80, 0x00,
		0x00 };

const unsigned char ingranaggioInv[] = { 0xff, 0xc0, 0x92, 0x40, 0x80, 0x40,
		0xc0, 0xc0, 0x8c, 0x40, 0x8c, 0x40, 0xc0, 0xc0, 0x80, 0x40, 0x92, 0x40,
		0xff, 0xc0 };

const unsigned char attivo[] =
		{ 0xff, 0xc0, 0x80, 0x40, 0x81, 0x40, 0x83, 0x40, 0x86, 0x40, 0xac,
				0x40, 0xb8, 0x40, 0x90, 0x40, 0x80, 0x40, 0xff, 0xc0, };

const unsigned char attivoInv[] = { 0x00, 0x00, 0x7f, 0x80, 0x7e, 0x80, 0x7c,
		0x80, 0x79, 0x80, 0x53, 0x80, 0x47, 0x80, 0x6f, 0x80, 0x7f, 0x80, 0x00,
		0x00 };

const unsigned char nonAttivo[] = { 0xff, 0xc0, 0x80, 0x40, 0x80, 0x40, 0x80,
		0x40, 0x80, 0x40, 0x80, 0x40, 0x80, 0x40, 0x80, 0x40, 0x80, 0x40, 0xff,
		0xc0 };

const unsigned char nonAttivoInv[] = { 0x00, 0x00, 0x7f, 0x80, 0x7f, 0x80, 0x7f,
		0x80, 0x7f, 0x80, 0x7f, 0x80, 0x7f, 0x80, 0x7f, 0x80, 0x7f, 0x80, 0x00,
		0x00 };

#endif /* INC_BITMAP_H_ */
