FloppyO1/Automatic-Pet-Feeder/firmware/automatic pet feeder/Core/Src/DS3231lib.c

/*
 * DS3231lib.c
 *
 *  Created on: Jan 12, 2023
 *      Author: Filippo Castellan
 */

#include "DS3231lib.h"

/* convert normal decimal numbers to binary coded decimal */
uint8_t decToBcd(int val) {
	return (uint8_t) ((val / 10 * 16) + (val % 10));
}

/* convert binary coded decimal to normal decimal numbers */
int bcdToDec(uint8_t val) {
	return (int) ((val / 16 * 10) + (val % 16));
}

/* function to set time */
void Set_Time(uint8_t sec, uint8_t min, uint8_t hour, uint8_t dow, uint8_t dom,
		uint8_t month, uint8_t year, I2C_HandleTypeDef *i2c) {
	uint8_t set_time[7];
	set_time[0] = decToBcd(sec);
	set_time[1] = decToBcd(min);
	set_time[2] = decToBcd(hour);
	set_time[3] = decToBcd(dow);
	set_time[4] = decToBcd(dom);
	set_time[5] = decToBcd(month);
	set_time[6] = decToBcd(year);

	//HAL_NVIC_DisableIRQ(EXTI4_15_IRQn);
	HAL_I2C_Mem_Write(i2c, DS3231_ADDRESS, 0x00, 1, set_time, 7, 1000);
	//HAL_NVIC_EnableIRQ(EXTI4_15_IRQn);
}

/* function read the time */
TIME Get_Time(I2C_HandleTypeDef *i2c) {
	TIME time;
	uint8_t get_time[7];
	//HAL_NVIC_DisableIRQ(EXTI4_15_IRQn);
	HAL_I2C_Mem_Read(i2c, DS3231_ADDRESS, 0x00, 1, get_time, 7, 1000);
	//HAL_NVIC_EnableIRQ(EXTI4_15_IRQn);
	time.seconds = bcdToDec(get_time[0]);
	time.minutes = bcdToDec(get_time[1]);
	time.hour = bcdToDec(get_time[2]);
	time.dayofweek = bcdToDec(get_time[3]);
	time.dayofmonth = bcdToDec(get_time[4]);
	time.month = bcdToDec(get_time[5]);
	time.year = bcdToDec(get_time[6]);
	return time;
}
