FloppyO1/Automatic-Pet-Feeder/(commit log)

2024-02-22 added all the files
    [ASSIEME dispenser.SLDASM, Assieme case circuito.3MF, Assieme case circuito.SLDASM, Assieme1 completo.SLDASM, Bursolotto.SLDPRT, LID1.SLDPRT, LID2.SLDPRT, LID3.SLDPRT]
2024-03-27 pet feeder stm32ide project
