FloppyO1/Automatic-Pet-Feeder/(notices)

Notices in the files:
firmware/automatic pet feeder/Core/Src/main.c:
Copyright (c) 2022 STMicroelectronics.
All rights reserved.
This software is licensed under terms that can be found in the LICENSE file
